dojoe/eagle/README

Some Eagle projects I am or have been working on.

  Atmega32U4-Breakout   - A breakout board for the Atmega32U4 uC
