dojoe/eagle/Atmega32U4-Breakout/v3/bom.ods

Qty | Device | Package | Value | Parts | Digikey | Unit price | Total
1 | ATmega32U4 | TQFP44 |  | U1 | ATMEGA32U4-AURCT-ND | 4,43 | 4,43
1 | Crystal Abracom ABM7 | ABM7 | 16MHz | XTAL | 535-9840-1-ND | 0,63 | 0,63
1 | Mini-USB receptacle |  | Hirose UX60-MB-5ST | USB | H2959CT-ND | 0,68 | 0,68
1 | REG1117 | SOT223 | AP1117 | IC1 | AP1117IE33G-13DICT-ND | 0,22 | 0,22
1 | SMD LED | 0805 | GREEN | POWER | 754-1131-1-ND | 0,07 | 0,07
1 | SMD LED | 0805 | RED | LED | 754-1132-1-ND | 0,09 | 0,09
2 | SMD Tactile Switch | KMR2NG | C&K RS-282G05A3-SM RT | BOOT, RESET | CKN10384CT-ND | 0,58 | 1,15
1 | SMD PTC Fuse | 1206 | 0,5A hold, 1A trip | F1 | F3733CT-ND | 0,25 | 0,25
5 | SMD Ceramic Cap | 0603 | 100n | C4, C5, C6, C7, C8 |  | 0,00 | 0,02
1 | SMD Ceramic Cap | 0805 | 10u | C10 | 1276-1764-1-ND | 0,10 | 0,10
2 | SMD Ceramic Cap | 0603 | 18p | C2, C3 | 1276-2210-1-ND | 0,01 | 0,01
1 | SMD Ceramic Cap | 0603 | 1u | C1 | 1276-1946-1-ND | 0,02 | 0,02
1 | SMD Ceramic Cap | 1206 | 22u X7R | C11 | 1276-2769-1-ND | 0,21 | 0,21
2 | SMD Resistor | 0603 | 10k | R3, R4 | RHM10KCGCT-ND | 0,00 | 0,01
2 | SMD Resistor | 0603 | 22 | R1, R2 | RHM22CGCT-ND | 0,00 | 0,01
1 | SMD Resistor | 0603 | 150 | R6 | RHM150CGCT-ND | 0,00 | 0,00
1 | SMD Resistor | 0603 | 180 | R5 | RHM180CGCT-ND | 0,00 | 0,00
1 | PCB |  |  |  |  | 1,5 | 1,50
1 | Static shielding bag |  |  |  | 16-1032-ND | 0,08 | 0,08
 |  |  |  |  |  |  | 9,5 | Total excl. VAT
 |  |  |  |  |  |  | 11,3 | incl. VAT
