dojoe/eagle/Atmega32U4-Breakout/v3/atmega32u4-breakout-v3.brd

## EAGLE design Atmega32U4-Breakout/v3/atmega32u4-breakout-v3.brd (2014-09-21)

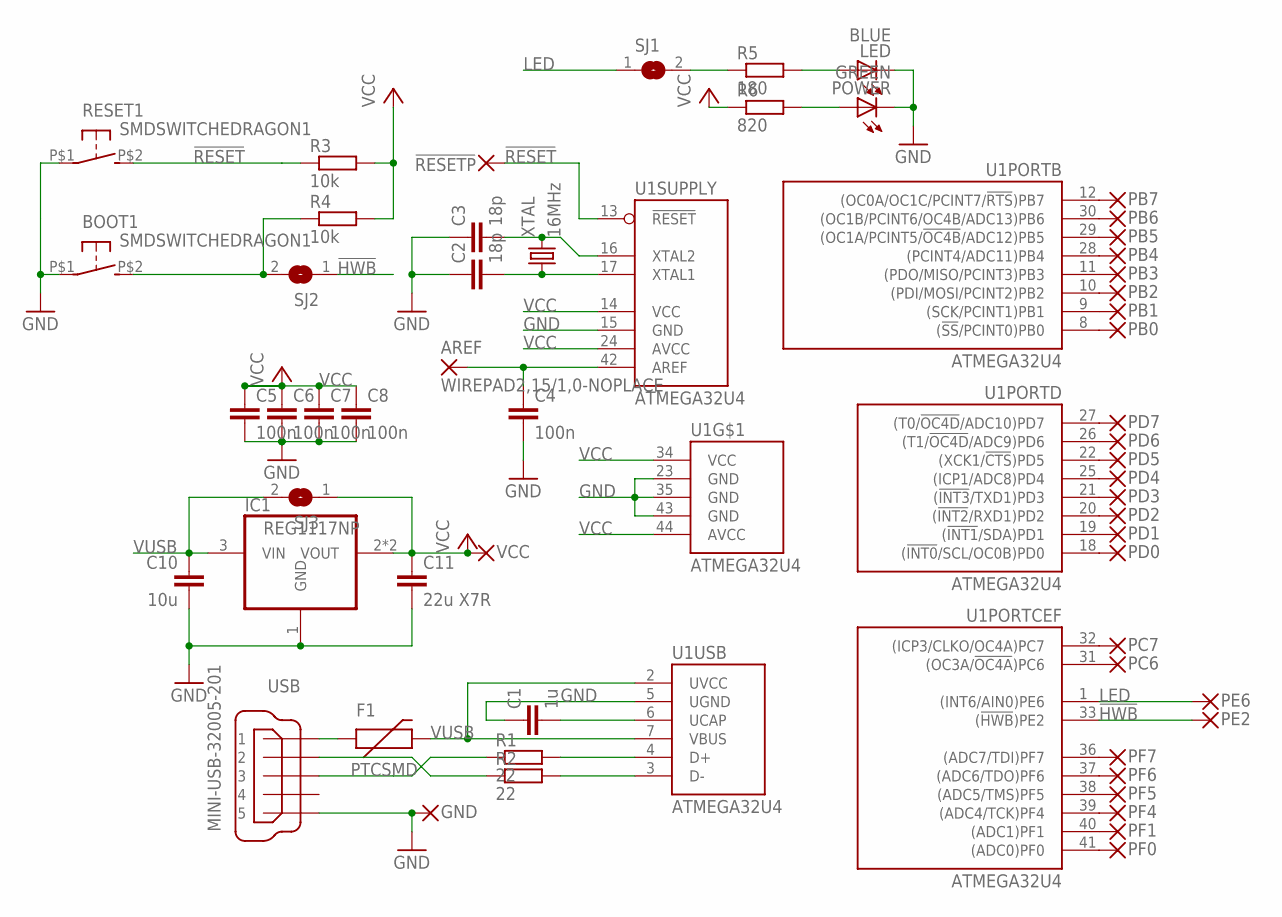
[picture p1: schematic atmega32u4-breakout-v3.sch]

Parts:
!RESETP: WIREPAD2,15/1,0-NOPLACE; 2,15/1,0-NOPLACE
AREF: WIREPAD2,15/1,0-NOPLACE; 2,15/1,0-NOPLACE
BOOT1: SMDSWITCHEDRAGON1; EDRAGON1
C1: 1u; C0603
C2, C3: 18p; C0603
C4, C5, C6, C7, C8: 100n; C0603
C10: 10u; C0805K
C11: 22u X7R; C1206K
F1: PTCSMD; PTC-1206
GND: WIREPAD2,15/1,0-NOPLACE; 2,15/1,0-NOPLACE
IC1: REG1117NP; SOT223-NP
LED: BLUE; CHIPLED_0805
PB0, PB1, PB2, PB3, PB4, PB5, PB6, PB7: WIREPAD2,15/1,0-NOPLACE; 2,15/1,0-NOPLACE
PC6, PC7: WIREPAD2,15/1,0-NOPLACE; 2,15/1,0-NOPLACE
PD0, PD1, PD2, PD3, PD4, PD5, PD6, PD7: WIREPAD2,15/1,0-NOPLACE; 2,15/1,0-NOPLACE
PE2, PE6: WIREPAD2,15/1,0-NOPLACE; 2,15/1,0-NOPLACE
PF0, PF1, PF4, PF5, PF6, PF7: WIREPAD2,15/1,0-NOPLACE; 2,15/1,0-NOPLACE
POWER: GREEN; CHIPLED_0805
R1, R2: 22; R0603
R3, R4: 10k; R0603
R5: 180; R0603
R6: 820; R0603
RESET1: SMDSWITCHEDRAGON1; EDRAGON1
SJ1, SJ2: SJ
SJ3: SJNP
U1: ATMEGA32U4; TQFP44
USB: MINI-USB-32005-201; 32005-201
VCC: WIREPAD2,15/1,0-NOPLACE; 2,15/1,0-NOPLACE
XTAL: 16MHz; ABM7

Connections:
!HWB: PE2.1, SJ2.1, U1.33 ((!HWB!)PE2)
!RESET: !RESETP.1, R3.1, RESET1.P$2 (S), U1.13 (!RESET)
AREF: AREF.1, C4.1, U1.42 (AREF)
GND: BOOT1.P$1, C1.1, C2.1, C3.1, C4.2, C5.2, C6.2, C7.2, C8.2, C10.2, C11.2, GND.1, IC1.1 (GND), LED.C, POWER.C, RESET1.P$1, U1.5 (UGND), U1.15 (GND), U1.23 (GND), U1.35 (GND), U1.43 (GND), USB.5
LED: PE6.1, SJ1.1, U1.1 ((INT6/AIN0)PE6)
MISO: PB3.1, U1.11 ((PDO/MISO/PCINT3)PB3)
MOSI: PB2.1, U1.10 ((PDI/MOSI/PCINT2)PB2)
unnamed: R1.1, USB.3
unnamed: R2.1, USB.2
unnamed: PB0.1, U1.8 ((!SS!/PCINT0)PB0)
unnamed: F1.1, USB.1
unnamed: C2.2, U1.17 (XTAL1), XTAL.P$1 (1)
unnamed: C3.2, U1.16 (XTAL2), XTAL.P$2 (2)
unnamed: C1.2, U1.6 (UCAP)
unnamed: POWER.A, R6.2
unnamed: R1.2, U1.4 (D+)
unnamed: R2.2, U1.3 (D-)
unnamed: R5.1, SJ1.2
unnamed: PD5.1, U1.22 ((XCK1/!CTS!)PD5)
unnamed: PB4.1, U1.28 ((PCINT4/ADC11)PB4)
unnamed: PB5.1, U1.29 ((OC1A/PCINT5/!OC4B!/ADC12)PB5)
unnamed: PF0.1, U1.41 ((ADC0)PF0)
unnamed: PF1.1, U1.40 ((ADC1)PF1)
unnamed: PF4.1, U1.39 ((ADC4/TCK)PF4)
unnamed: PF5.1, U1.38 ((ADC5/TMS)PF5)
unnamed: PF6.1, U1.37 ((ADC6/TDO)PF6)
unnamed: PF7.1, U1.36 ((ADC7/TDI)PF7)
unnamed: BOOT1.P$2 (S), R4.1, SJ2.2
unnamed: LED.A, R5.2
unnamed: PC6.1, U1.31 ((OC3A/!OC4A!)PC6)
unnamed: PC7.1, U1.32 ((ICP3/CLKO/OC4A)PC7)
unnamed: PB6.1, U1.30 ((OC1B/PCINT6/OC4B/ADC13)PB6)
unnamed: PB7.1, U1.12 ((OC0A/OC1C/PCINT7/!RTS!)PB7)
unnamed: PD0.1, U1.18 ((!INT0!/SCL/OC0B)PD0)
unnamed: PD1.1, U1.19 ((!INT1!/SDA)PD1)
unnamed: PD2.1, U1.20 ((!INT2!/RXD1)PD2)
unnamed: PD3.1, U1.21 ((!INT3!/TXD1)PD3)
unnamed: PD4.1, U1.25 ((ICP1/ADC8)PD4)
unnamed: PD6.1, U1.26 ((T1/!OC4D!/ADC9)PD6)
unnamed: PD7.1, U1.27 ((T0/!OC4D!/ADC10)PD7)
SCK: PB1.1, U1.9 ((SCK/PCINT1)PB1)
VCC: C5.1, C6.1, C7.1, C8.1, C11.1, IC1.2 (VOUT), IC1.4 (VOUT), R3.2, R4.2, R6.1, SJ3.1, U1.14 (VCC), U1.24 (AVCC), U1.34 (VCC), U1.44 (AVCC), VCC.1
VUSB: C10.1, F1.2, IC1.3 (VIN), SJ3.2, U1.2 (UVCC), U1.7 (VBUS)

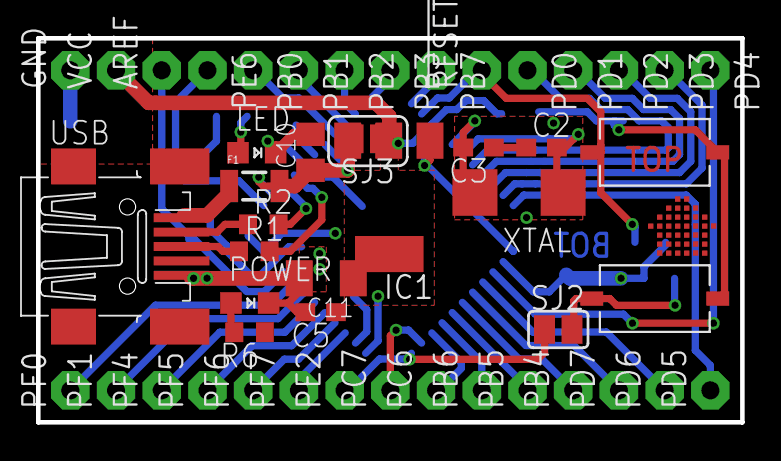
[picture p2: board atmega32u4-breakout-v3.brd from above]

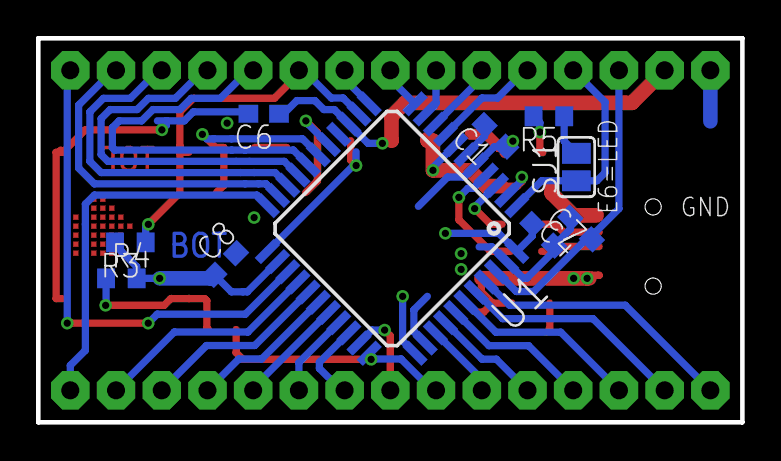
[picture p3: board atmega32u4-breakout-v3.brd from below]

Board: 2 copper layers, 39.1 x 21.3 mm, 58 parts (10 on the bottom side), 43 nets.
