dojoe/eagle/Atmega32U4-Breakout/v3/instructions.pdf

# TinyMega Board v2

## Assembly Instructions

by @dop3j0e

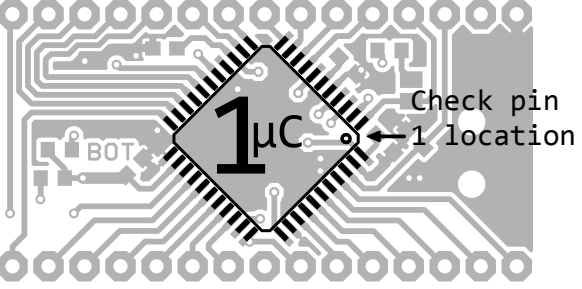
[picture p4: figure]
Check pin 1 location

Except for the µC and the LEDs (and the obvious like USB jack), orientation never matters.

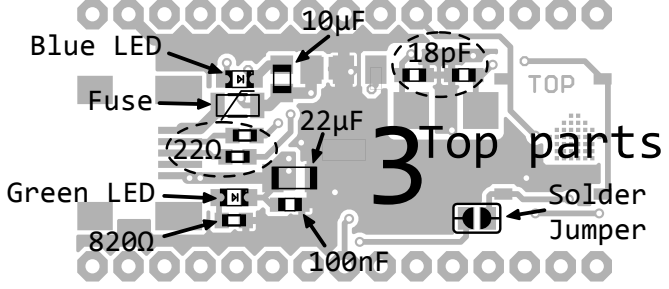
[picture p5: figure]
3 Top parts; Blue LED; Green LED; Fuse; Solder Jumper
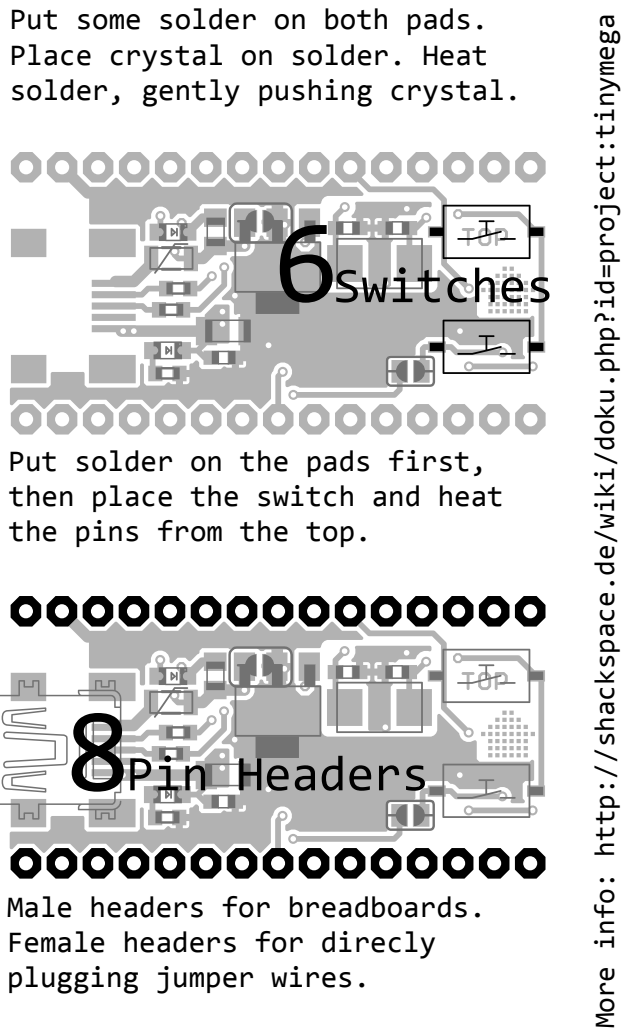
[picture p6: figure]
6Switches; Put solder on the pads first, then place the switch and heat the pins from the top.; Put some solder on both pads. Place crystal on solder. Heat solder, gently pushing crystal.; 8Pin Headers; Male headers for breadboards. Female headers for direcly plugging jumper wires.; More info: http://shackspace.de/wiki/doku.php?id=project:tinymega

Start with the parts at the left and continue to the right.
LED cathodes are marked.

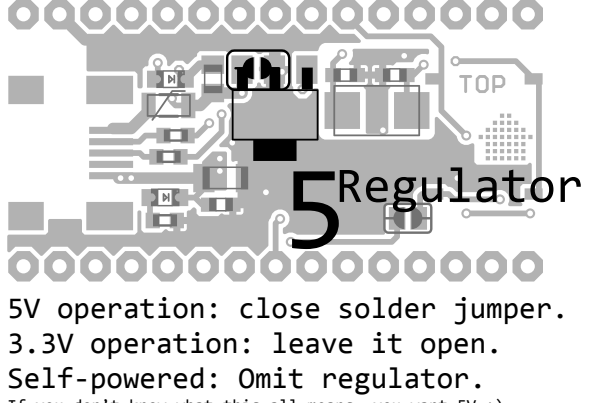
[picture p7: figure]
5 Regulator; 5V operation: close solder jumper. 3.3V operation: leave it open. Self-powered: Omit regulator.
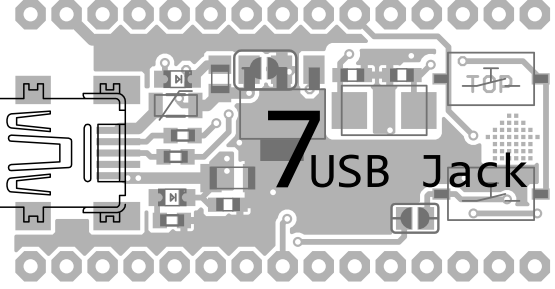
[picture p8: figure]
7 USB Jack

Solder the pins first. Check the solder joints. Then solder down the shield.

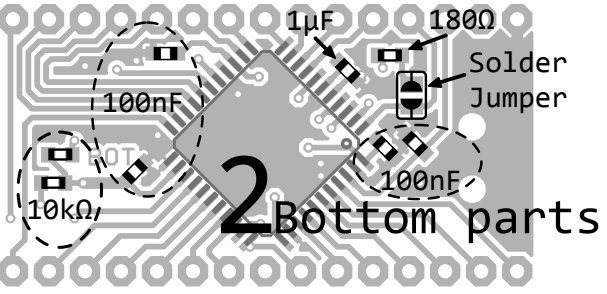
[picture p9: figure]
2 Bottom parts; Solder Jumper

For the solder jumper, heat both pads and add lots of solder until they connect.

If you dont know what this all means, you want 5V ;)

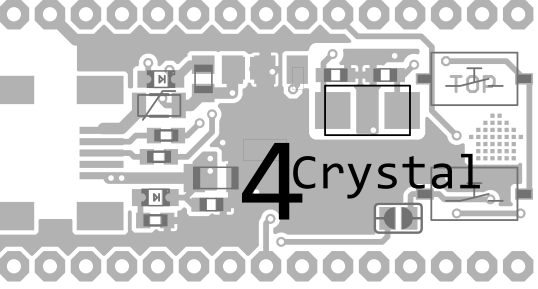
[picture p10: figure]
4Crystal
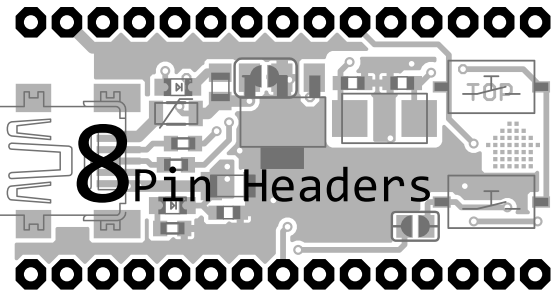
[picture p11: figure]
