dojoe/eagle/(commit log)

2012-01-12 Initial commit, add v1 and v2 of the Atmega32U4 Breakout
    [atmega32u4-breakout-v1-panelized.brd, atmega32u4-breakout-v1.brd, atmega32u4-breakout-v1.sch, atmega32u4-breakout-v2-panelized.brd, atmega32u4-breakout-v2.1-panelized.brd, atmega32u4-breakout-v2.1.brd, atmega32u4-breakout-v2.1.sch, atmega32u4-breakout-v2.brd]
2012-01-12 Add double-sided v3 of the ATmega32U4 board
    [atmega32u4-breakout-v3.brd, atmega32u4-breakout-v3.sch, bom.ods]
2012-02-11 - Add silkscreen line between LED resistors so their orientation becomes more clear. - Change green LED resistor to 150R - Change input filter cap to 0805 4.7uF - Match BOM
    [atmega32u4-breakout-v3.brd, atmega32u4-breakout-v3.sch, bom.ods]
2012-02-11 Add assembly instructions
2012-03-10 Update instructions with solder jumpers
2012-03-10 Straighten a few bits of the layout, adapt to switches with ground pin. Also, match BOM.
    [atmega32u4-breakout-v3.brd, atmega32u4-breakout-v3.sch, bom.ods]
2014-04-26 TinyMega v2 with optional 3V3 supply
    [atmega32u4-breakout-v3.brd, atmega32u4-breakout-v3.sch, bom.ods]
2014-04-26 Change LED silkscreen for more clarity
    [atmega32u4-breakout-v3.brd, atmega32u4-breakout-v3.sch]
2014-05-17 Change button model, make vias smaller, adapt to multi-circuit-boards design rules, lots of small routing changes
    [atmega32u4-breakout-v3.brd, atmega32u4-breakout-v3.sch, bom.ods]
2014-05-17 change USB plug package, rearrange bottom solder jumper
    [atmega32u4-breakout-v3.brd, atmega32u4-breakout-v3.sch]
2014-05-17 Add resettable fuse, rearrange stuff
    [atmega32u4-breakout-v3.brd, atmega32u4-breakout-v3.sch, bom.ods]
2014-06-09 Update BOM with more Digi-Key part numbers
    [bom.ods]
2014-07-09 Add TOP and BOT markers, shuffle some things around
    [atmega32u4-breakout-v3.brd]
2014-07-21 Nudge some more stuff around, change silkscreen, add large GND pad on bottom, add multicb gerber job
    [atmega32u4-breakout-v3.brd, atmega32u4-breakout-v3.sch]
2014-07-21 Add dimension output to Gerber job
2014-09-21 Change red LED to blue, adapt dropper resistor
    [atmega32u4-breakout-v3.brd, atmega32u4-breakout-v3.sch]
2014-09-21 Update assembly instructions for new board
2014-10-02 Instructions: Swap crystal and regulator steps, add Wiki link
